mayvid22/Solinas-Product-Design-Challenge/Solinas CAD/Mount/stand assembly/top motor/_MS-MF.step

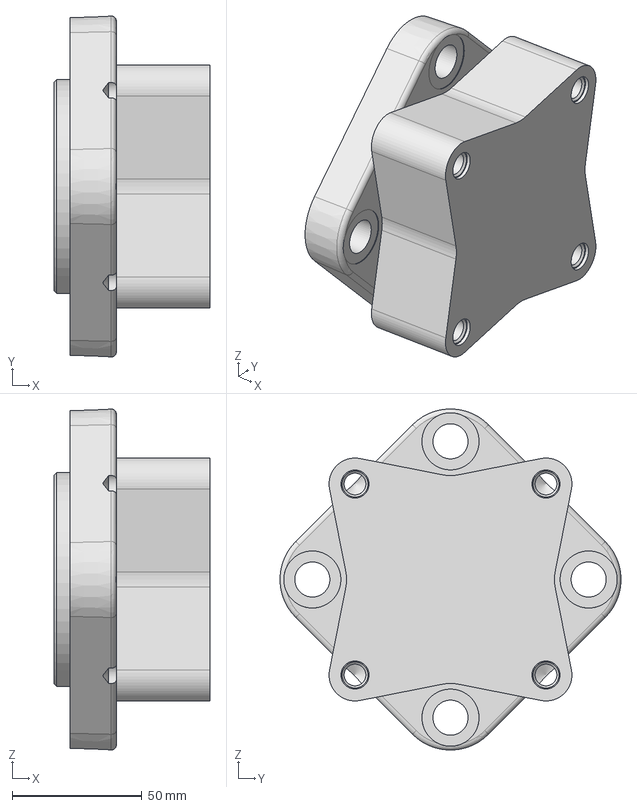
[picture p1: CAD file, 2024-07-06]
Solinas CAD/Mount/stand assembly/top motor/_MS-MF.step
60.0 x 131.3 x 131.3 mm
